trychlos/mysPowerS0/build/mysPowerS0.ods

Sheet: Notes
About mySensorsIDs
 | Homogeneize the namings : minPeriod, maxPeriod vs minFrequency, maxFrequency → choose one of Period or Frequency
 | Try to make pwiSensors simpler
About Board
 | Have a switch to on/off the power of the board
 | Have better external connections

Sheet: NanoConnections
 |  |  | Digital | Analog |  | MySensors | NRF24L01 |  | DRS155D n° 1 | DRS155D n° 2 | DRS155D n° 3 | DRS155D n° 4
1 | TX | Reserved UART |  |  | PCINT2 Port D
2 | RX | Reserved UART
3 | RST
4 | GND |  |  |  |  |  | 1 | GND | So - | So - | So - | So -
5 | D2 / IRQ0 |  |  |  |  |  | 5 | IRQ
6 | D3 / IRQ1 |  | √ |  |  |  |  |  | Enabled
7 | D4 |  | √ |  |  |  |  |  |  | Enabled
8 | D5 |  | √ |  |  |  |  |  |  |  | Enabled
9 | D6 |  | √ |  |  |  |  |  |  |  |  | Enabled
10 | D7 |  | √ |  |  |  |  |  | LED
11 | D8 |  | √ |  | PCINT0 Port B |  |  |  |  | LED
12 | D9 |  |  |  |  |  | 2 | CE
13 | D10 |  |  |  |  |  | 7 | CSN
14 | D11 |  |  |  |  |  | 6 | MOSI
15 | D12 |  |  |  |  |  | 4 | MISO
16 | D13 |  |  |  |  |  | 3 | SCK
17 | 3V3 |  |  |  |  |  | 8 | VCC
18 | AREF
19 | A0 |  | √ | √ | PCINT1 Port C |  |  |  | So +
20 | A1 |  | √ | √ |  |  |  |  |  | So +
21 | A2 |  | √ | √ |  |  |  |  |  |  | So +
22 | A3 |  | √ | √ |  |  |  |  |  |  |  | So +
23 | A4 |  | √ | √ |  |  |  |  |  |  | LED
24 | A5 |  | √ | √ |  |  |  |  |  |  |  | LED
25 | A6 |  |  | √
26 | A7 |  |  | √ |  | MY_RANDOMSEED_PIN
27 | +5V
28 | RST
29 | GND
30 | VIN

Sheet: mySensors IDs v4
Arduino sensor |  |  |  |  |  |  | mySensor event
Sens | Name | Alias | Id | Type | Comment | pwiSensor | Nature | Command | Message | Payload | Comment
Out | CHILD_MAIN+0 | CHILD_MAIN_LOG | 1 | S_INFO | General command target |  | Info |  | V_TEXT | <text> | Informations sent from the node to the controller, let the node send a textual log line
In | CHILD_MAIN+1 | CHILD_MAIN_ACTION_RESET | 2 | S_BINARY | General commands target |  | Action | C_SET | V_STATUS | 1=”ON” | EEPROM reset
In | CHILD_MAIN+2 | CHILD_MAIN_ACTION_DUMP | 3 | S_BINARY | General commands target |  | Action | C_SET | V_STATUS | 1=”ON” | Dump data
In | CHILD_MAIN+3 | CHILD_MAIN_ACTION_SAVE | 4 | S_BINARY | General commands target |  | Action | C_SET | V_STATUS | 1=”ON” | Write current energies into the EEPROM
In/Out | CHILD_MAIN+5 | CHILD_MAIN_PARM_SAVE_PERIOD | 6 | S_INFO | General commands target |  | Parm | C_SET | V_TEXT | <ms> | Set auto-save delay ; default=86400000 (24h)
In/Out | CHILD_MAIN+6 | CHILD_MAIN_PARM_DUMP_PERIOD | 7 | S_INFO | General command target |  | Parm | C_SET | V_TEXT | <ms> | set periodic resend of the full data ; 0 to disable ; default=86400000 (24h)
In/Out | CHILD_MAIN+7 | CHILD_MAIN_PARM_MIN_PERIOD | 8 | S_INFO | General command target |  | Parm | C_SET | V_TEXT | <ms> | min period of the measures
In/Out | CHILD_MAIN+8 | CHILD_MAIN_PARM_MAX_PERIOD | 9 | S_INFO | General command target |  | Parm | C_SET | V_TEXT | <ms> | max period of the measures
Out | CHILD_ID_PULSE_1 |  | 10 | S_POWER | Module n° 1 | pwiSensor | Info |  | V_WATT, V_KWH |  | Puissance, énergie
In/Out | CHILD_ID_PULSE_1+1 |  | 11 | S_INFO | Module n° 1 |  | Parm | C_SET | V_TEXT | <impkwh> | count of impulsions per kwh ; default=0
In/Out | CHILD_ID_PULSE_1+2 |  | 12 | S_INFO | Module n° 1 |  | Parm | C_SET | V_TEXT | <implen> | impulsion length ; default=0
In/Out | CHILD_ID_PULSE_1+3 |  | 13 | S_INFO | Module n° 1 |  | Parm | C_SET | V_TEXT | <name> | measure module name ; default=””
In/Out | CHILD_ID_PULSE_1+4 |  | 14 | S_INFO | Module n° 1 |  | Parm | C_SET | V_TEXT | <kwh> | set current energy measure once, so that the energy sent is aligned on the module display this is sent back to the controller when set, but never sent back again, nor stored, nor reused in anyway
Out | CHILD_ID_PULSE_2 |  | 20 | S_POWER | Module n° 1 | pwiSensor | Info |  | V_WATT, V_KWH |  | Puissance, énergie
In/Out | CHILD_ID_PULSE_2+1 |  | 21 | S_INFO | Module n° 1 |  | Parm | C_SET | V_TEXT | <impkwh> | count of impulsions per kwh ; default=0
In/Out | CHILD_ID_PULSE_2+2 |  | 22 | S_INFO | Module n° 1 |  | Parm | C_SET | V_TEXT | <implen> | impulsion length ; default=0
In/Out | CHILD_ID_PULSE_2+3 |  | 23 | S_INFO | Module n° 1 |  | Parm | C_SET | V_TEXT | <name> | measure module name ; default=””
In/Out | CHILD_ID_PULSE_2+4 |  | 24 | S_INFO | Module n° 1 |  | Parm | C_SET | V_TEXT | <kwh> | set current energy measure once, so that the energy sent is aligned on the module display this is sent back to the controller when set, but never sent back again, nor stored, nor reused in anyway
Out | CHILD_ID_PULSE_3 |  | 30 | S_POWER | Module n° 1 | pwiSensor | Info |  | V_WATT, V_KWH |  | Puissance, énergie
In/Out | CHILD_ID_PULSE_3+1 |  | 31 | S_INFO | Module n° 1 |  | Parm | C_SET | V_TEXT | <impkwh> | count of impulsions per kwh ; default=0
In/Out | CHILD_ID_PULSE_3+2 |  | 32 | S_INFO | Module n° 1 |  | Parm | C_SET | V_TEXT | <implen> | impulsion length ; default=0
In/Out | CHILD_ID_PULSE_3+3 |  | 33 | S_INFO | Module n° 1 |  | Parm | C_SET | V_TEXT | <name> | measure module name ; default=””
In/Out | CHILD_ID_PULSE_3+4 |  | 34 | S_INFO | Module n° 1 |  | Parm | C_SET | V_TEXT | <kwh> | set current energy measure once, so that the energy sent is aligned on the module display this is sent back to the controller when set, but never sent back again, nor stored, nor reused in anyway
Out | CHILD_ID_PULSE_4 |  | 40 | S_POWER | Module n° 1 | pwiSensor | Info |  | V_WATT, V_KWH |  | Puissance, énergie
In/Out | CHILD_ID_PULSE_4+1 |  | 41 | S_INFO | Module n° 1 |  | Parm | C_SET | V_TEXT | <impkwh> | count of impulsions per kwh ; default=0
In/Out | CHILD_ID_PULSE_4+2 |  | 42 | S_INFO | Module n° 1 |  | Parm | C_SET | V_TEXT | <implen> | impulsion length ; default=0
In/Out | CHILD_ID_PULSE_4+3 |  | 43 | S_INFO | Module n° 1 |  | Parm | C_SET | V_TEXT | <name> | measure module name ; default=””
In/Out | CHILD_ID_PULSE_4+4 |  | 44 | S_INFO | Module n° 1 |  | Parm | C_SET | V_TEXT | <kwh> | set current energy measure once, so that the energy sent is aligned on the module display This is sent back to the controller when set, but never sent back again, nor stored, nor reused in anyway

Sheet: mySensors IDs v3
Arduino sensor |  |  |  |  |  | mySensor event
Sens | Name | Id | Type | Comment | pwiSensor | Nature | Command | Message | Payload | Comment
In | CHILD_MAIN | 1 | S_CUSTOM | General commands target |  | Action | C_REQ | V_CUSTOM | 1 | EEPROM reset
In | CHILD_MAIN | 1 | S_CUSTOM | General commands target |  | Action | C_REQ | V_CUSTOM | 2 | Dump data
In | CHILD_MAIN | 1 | S_CUSTOM | General commands target |  | Action | C_REQ | V_CUSTOM | 3 | Write current energies into the EEPROM
In | CHILD_MAIN+1 | 2 | S_CUSTOM | General commands target |  | Action | C_SET | V_CUSTOM | <ms> | Set max frequency of the messages (minPeriod) ; default = 10000 (10s)
Out | CHILD_MAIN+1 | 2 | S_CUSTOM | General commands target |  | Info |  | V_VAR1 | <ms> | Max frequency of the messages (minPeriod)
In | CHILD_MAIN+2 | 3 | S_CUSTOM | General commands target |  | Action | C_SET | V_CUSTOM | <ms> | Set unchanged timeout of the messages (maxPeriod) ; default = 3600000 (1h)
Out | CHILD_MAIN+2 | 3 | S_CUSTOM | General commands target |  | Info |  | V_VAR1 | <ms> | Unchanged timeout of the messages (maxPeriod)
In | CHILD_MAIN+3 | 4 | S_CUSTOM | General commands target |  | Action | C_REQ | V_CUSTOM |  | Request count of enabled modules
Out | CHILD_MAIN+3 | 4 | S_CUSTOM | General commands target |  | Info |  | V_VAR1 | <count> | Count of enabled modules
In | CHILD_MAIN+4 | 5 | S_CUSTOM | General commands target |  | Action | C_SET | V_CUSTOM | <ms> | Set auto-save delay ; default = 604800000 (1 sem.)
Out | CHILD_MAIN+4 | 5 | S_CUSTOM | General commands target |  | Info |  | V_VAR1 | <ms> | Auto-save delay
In | CHILD_MAIN+5 | 6 | S_CUSTOM | General commands target |  | Action | C_SET | V_CUSTOM | <ms> | Set periodic resend of the full data ; 0 to disable ; default=86400000 (24h)
Out | CHILD_MAIN+5 | 6 | S_CUSTOM | General commands target |  | Info |  | V_VAR1 | <ms> | Periodic resend period of the full data
Out | CHILD_ID_PULSE_1 | 10 | S_POWER | Module n° 1 | pwiSensor | Info |  | V_WATT |  | Puissance instantanée
Out | CHILD_ID_PULSE_1+1 | 11 | S_POWER | Module n° 1 |  | Info |  | V_KWH |  | Consommation cumulée depuis le démarrage
In | CHILD_ID_PULSE_1+2 | 12 | S_POWER | Module n° 1 |  | Action | C_SET | V_CUSTOM | <impkwh> | set count of impulsions per kwh ; default = 1000 imp/kwh
Out | CHILD_ID_PULSE_1+2 | 12 | S_POWER | Module n° 1 |  | Info |  | V_VAR1 | <impkwh> | count of impulsions per kwh
In | CHILD_ID_PULSE_1+3 | 13 | S_POWER | Module n° 1 |  | Action | C_SET | V_CUSTOM | <implen> | set impulsion length ; default = 90 ms
Out | CHILD_ID_PULSE_1+3 | 13 | S_POWER | Module n° 1 |  | Info |  | V_VAR1 | <implen> | impulsion length
In | CHILD_ID_PULSE_1+4 | 14 | S_POWER | Module n° 1 |  | Action | C_SET | V_CUSTOM | <name> | set measure module name (e.g. DRS-155D)
Out | CHILD_ID_PULSE_1+4 | 14 | S_POWER | Module n° 1 |  | Info |  | V_VAR1 | <name> | module name
Out | CHILD_ID_PULSE_1+5 | 15 | S_POWER | Module n° 1 |  | Info |  | V_VAR1 | 1|0 | Whether the module is enabled
In | CHILD_ID_PULSE_1+6 | 16 | S_POWER | Module n° 1 |  | Action | C_SET | V_CUSTOM | <kwh> | set current DRS155-D measure
Out | CHILD_ID_PULSE_2 | 20 | S_POWER | Module n° 2 | pwiSensor | Info |  | V_WATT |  | Puissance instantanée
Out | CHILD_ID_PULSE_2+1 | 21 | S_POWER | Module n° 2 |  | Info |  | V_KWH |  | Consommation cumulée depuis le démarrage
In | CHILD_ID_PULSE_2+2 | 22 | S_POWER | Module n° 2 |  | Action | C_SET | V_CUSTOM | <impkwh> | set count of impulsions per kwh ; default = 1000 imp/kwh
Out | CHILD_ID_PULSE_2+2 | 22 | S_POWER | Module n° 2 |  | Info |  | V_VAR1 | <impkwh> | count of impulsions per kwh
In | CHILD_ID_PULSE_2+3 | 23 | S_POWER | Module n° 2 |  | Action | C_SET | V_CUSTOM | <implen> | set impulsion length ; default = 90 ms
Out | CHILD_ID_PULSE_2+3 | 23 | S_POWER | Module n° 2 |  | Info |  | V_VAR1 | <implen> | impulsion length
In | CHILD_ID_PULSE_2+4 | 24 | S_POWER | Module n° 2 |  | Action | C_SET | V_CUSTOM | <name> | set measure module name (e.g. DRS-155D)
Out | CHILD_ID_PULSE_2+4 | 24 | S_POWER | Module n° 2 |  | Info |  | V_VAR1 | <name> | module name
Out | CHILD_ID_PULSE_2+5 | 25 | S_POWER | Module n° 2 |  | Info |  | V_VAR1 | 1|0 | Whether the module is enabled
In | CHILD_ID_PULSE_2+6 | 26 | S_POWER | Module n° 2 |  | Action | C_SET | V_CUSTOM | <kwh> | set current DRS155-D measure
Out | CHILD_ID_PULSE_3 | 30 | S_POWER | Module n° 3 | pwiSensor | Info |  | V_WATT |  | Puissance instantanée
Out | CHILD_ID_PULSE_3+1 | 31 | S_POWER | Module n° 3 |  | Info |  | V_KWH |  | Consommation cumulée depuis le démarrage
In | CHILD_ID_PULSE_3+2 | 32 | S_POWER | Module n° 3 |  | Action | C_SET | V_CUSTOM | <impkwh> | set count of impulsions per kwh ; default = 1000 imp/kwh
Out | CHILD_ID_PULSE_3+2 | 32 | S_POWER | Module n° 3 |  | Info |  | V_VAR1 | <impkwh> | count of impulsions per kwh
In | CHILD_ID_PULSE_3+3 | 33 | S_POWER | Module n° 3 |  | Action | C_SET | V_CUSTOM | <implen> | set impulsion length ; default = 90 ms
Out | CHILD_ID_PULSE_3+3 | 33 | S_POWER | Module n° 3 |  | Info |  | V_VAR1 | <implen> | impulsion length
In | CHILD_ID_PULSE_3+4 | 34 | S_POWER | Module n° 3 |  | Action | C_SET | V_CUSTOM | <name> | set measure module name (e.g. DRS-155D)
Out | CHILD_ID_PULSE_3+4 | 34 | S_POWER | Module n° 3 |  | Info |  | V_VAR1 | <name> | module name
Out | CHILD_ID_PULSE_3+5 | 35 | S_POWER | Module n° 3 |  | Info |  | V_VAR1 | 1|0 | Whether the module is enabled
In | CHILD_ID_PULSE_3+6 | 36 | S_POWER | Module n° 3 |  | Action | C_SET | V_CUSTOM | <kwh> | set current DRS155-D measure
Out | CHILD_ID_PULSE_4 | 40 | S_POWER | Module n° 4 | pwiSensor | Info |  | V_WATT |  | Puissance instantanée
Out | CHILD_ID_PULSE_4+1 | 41 | S_POWER | Module n° 4 |  | Info |  | V_KWH |  | Consommation cumulée depuis le démarrage
In | CHILD_ID_PULSE_4+2 | 42 | S_POWER | Module n° 4 |  | Action | C_SET | V_CUSTOM | <impkwh> | set count of impulsions per kwh ; default = 1000 imp/kwh
Out | CHILD_ID_PULSE_4+2 | 42 | S_POWER | Module n° 4 |  | Info |  | V_VAR1 | <impkwh> | count of impulsions per kwh
In | CHILD_ID_PULSE_4+3 | 43 | S_POWER | Module n° 4 |  | Action | C_SET | V_CUSTOM | <implen> | set impulsion length ; default = 90 ms
Out | CHILD_ID_PULSE_4+3 | 43 | S_POWER | Module n° 4 |  | Info |  | V_VAR1 | <implen> | impulsion length
In | CHILD_ID_PULSE_4+4 | 44 | S_POWER | Module n° 4 |  | Action | C_SET | V_CUSTOM | <name> | set measure module name (e.g. DRS-155D)
Out | CHILD_ID_PULSE_4+4 | 44 | S_POWER | Module n° 4 |  | Info |  | V_VAR1 | <name> | module name
Out | CHILD_ID_PULSE_4+5 | 45 | S_POWER | Module n° 4 |  | Info |  | V_VAR1 | 1|0 | Whether the module is enabled
In | CHILD_ID_PULSE_4+6 | 46 | S_POWER | Module n° 4 |  | Action | C_SET | V_CUSTOM | <kwh> | set current DRS155-D measure
