trychlos/mysPowerS0/build/mysPowerS0.sch

## KiCad design build/mysPowerS0.sch (2017-04-17)

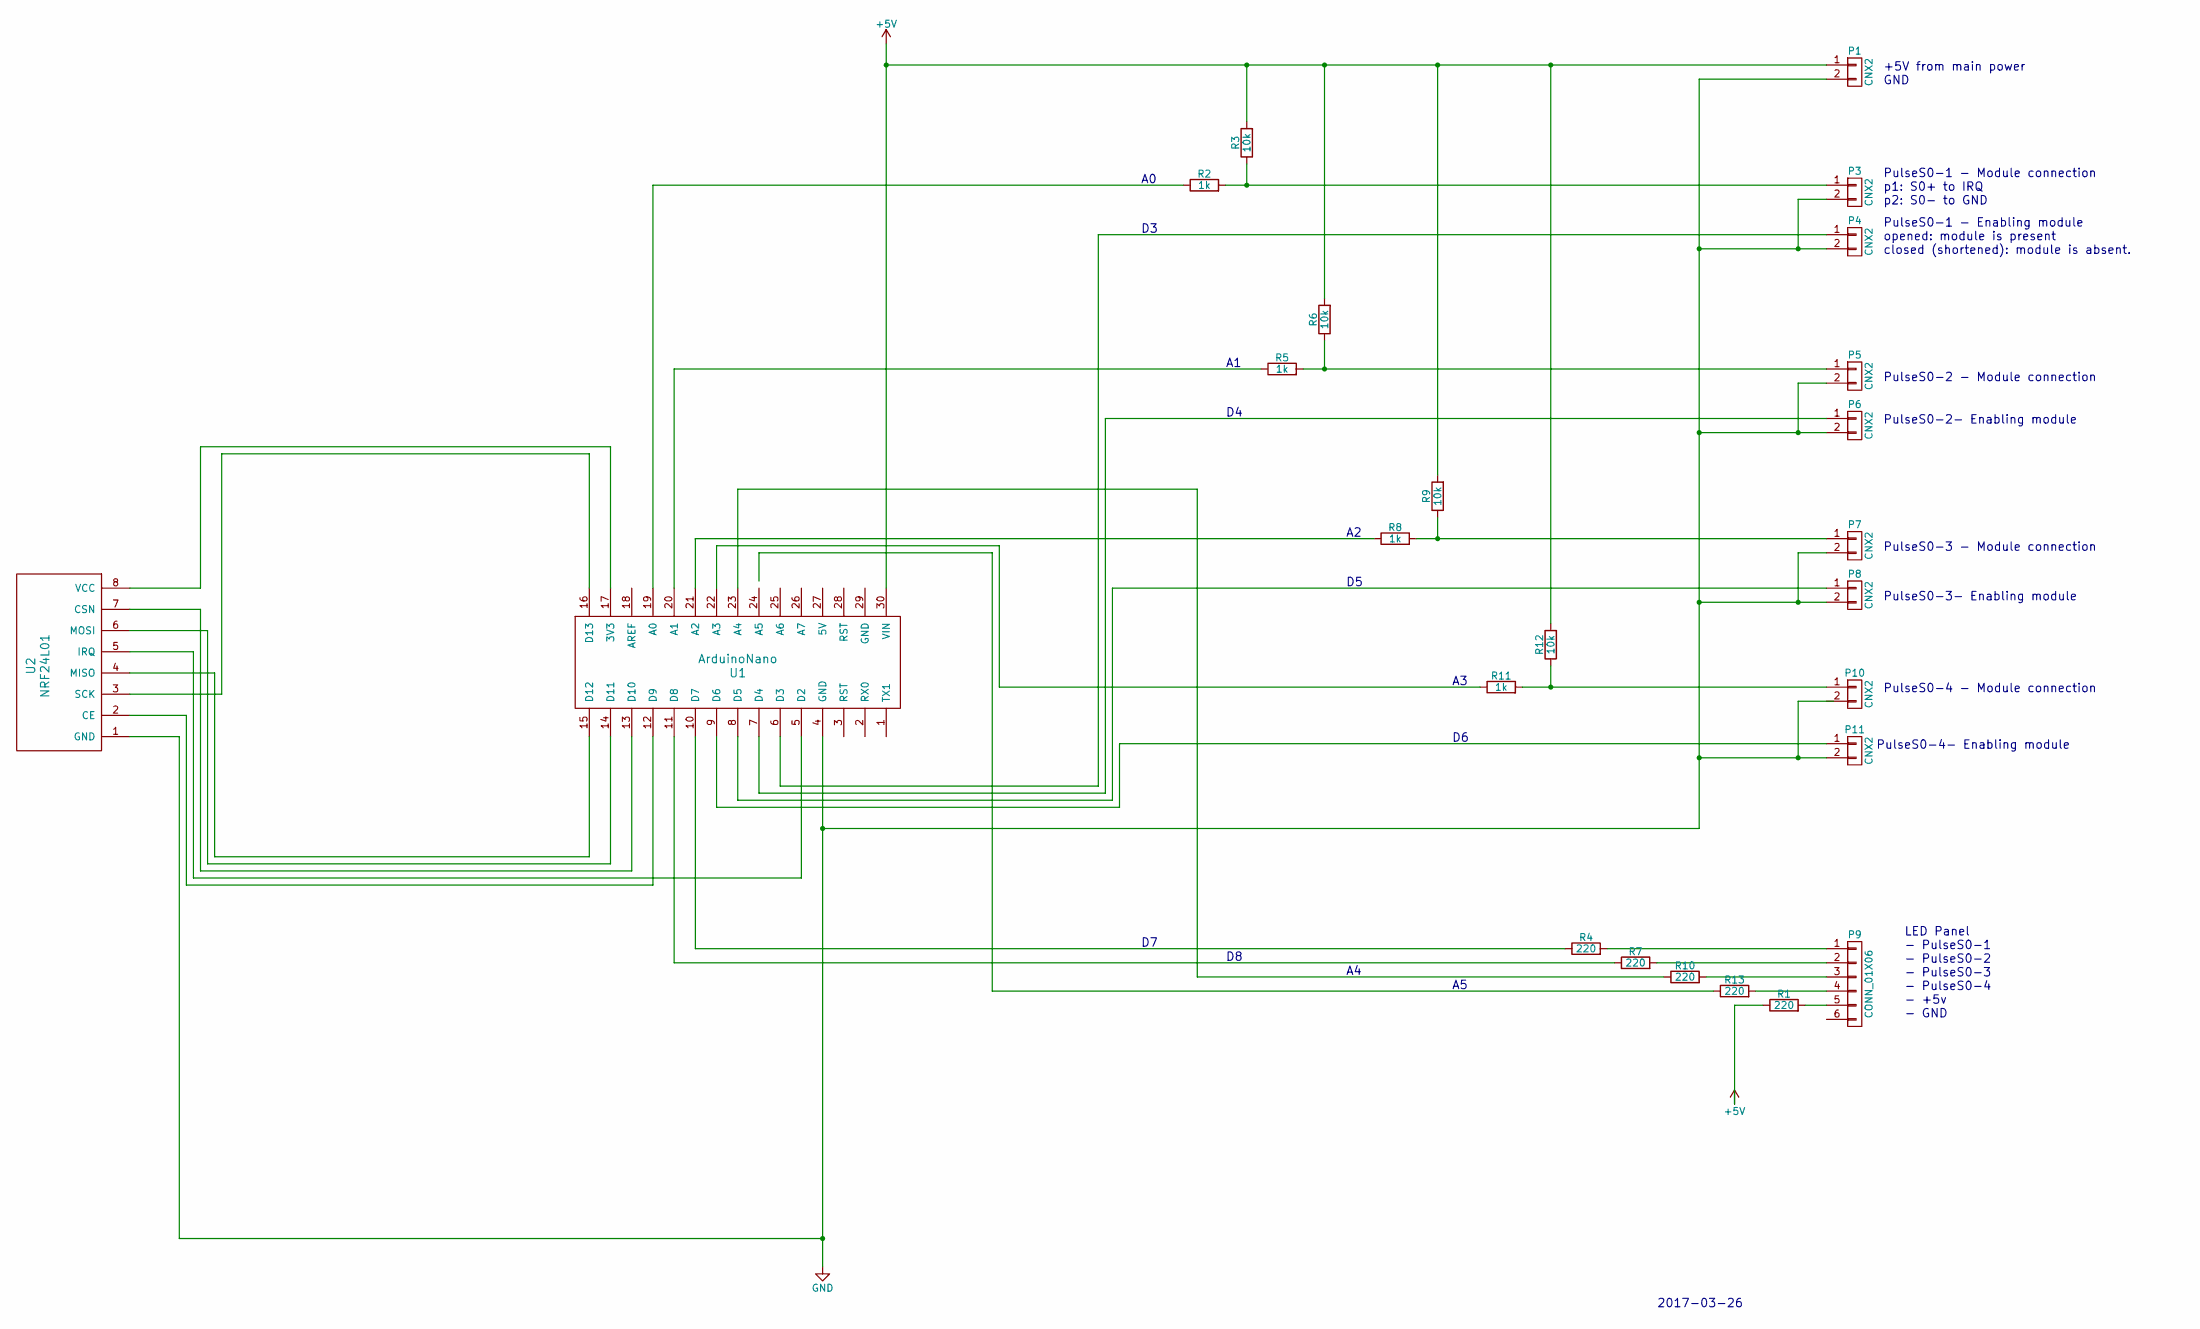
[picture p1: schematic mysPowerS0.sch]

Parts:
P1, P3, P4, P5, P6, P7, P8, P10, P11: CNX2
P9: CONN_01X06
R1, R4, R7, R10, R13: 220
R2, R5, R8, R11: 1k
R3, R6, R9, R12: 10k
U1: ArduinoNano
U2: NRF24L01

Connections:
+5V: P1.1, R1.1, R3.2, R6.2, R9.2, R12.2, U1.30 (VIN)
GND: P1.2, P3.2, P4.2, P5.2, P6.2, P7.2, P8.2, P11.2, U1.4 (GND), U2.1 (GND)
unnamed: P3.1, R2.2, R3.1
unnamed: P4.1, U1.6 (D3)
unnamed: P5.1, R5.2, R6.1
unnamed: P6.1, U1.7 (D4)
unnamed: P7.1, R8.2, R9.1
unnamed: P8.1, U1.8 (D5)
unnamed: P9.1, R4.2
unnamed: P9.2, R7.2
unnamed: P9.3, R10.2
unnamed: P9.4, R13.2
unnamed: P9.5, R1.2
unnamed: P10.1, R11.2, R12.1
unnamed: P11.1, U1.9 (D6)
unnamed: R2.1, U1.19 (A0)
unnamed: R4.1, U1.10 (D7)
unnamed: R5.1, U1.20 (A1)
unnamed: R7.1, U1.11 (D8)
unnamed: R8.1, U1.21 (A2)
unnamed: R10.1, U1.23 (A4)
unnamed: R11.1, U1.22 (A3)
unnamed: U1.5 (D2), U2.5 (IRQ)
unnamed: U1.12 (D9), U2.2 (CE)
unnamed: U1.13 (D10), U2.7 (CSN)
unnamed: U1.14 (D11), U2.6 (MOSI)
unnamed: U1.15 (D12), U2.4 (MISO)
unnamed: U1.16 (D13), U2.3 (SCK)
unnamed: U1.17 (3V3), U2.8 (VCC)

Notes on the sheet:
+5V from main power GND
2017-03-26
PulseS0-1 - Module connection p1: S0+ to IRQ p2: S0- to GND
PulseS0-1 - Enabling module opened: module is present closed (shortened): module is absent.
PulseS0-3 - Module connection
PulseS0-3- Enabling module
LED Panel - PulseS0-1 - PulseS0-2 - PulseS0-3 - PulseS0-4 - +5v - GND
PulseS0-2 - Module connection
PulseS0-2- Enabling module
PulseS0-4 - Module connection
PulseS0-4- Enabling module
