trychlos/mysPowerS0/(commit log)

2019-06-01 mysPowerS0: full rewrite with pwiSensor
    [NanoConnections.ods, Sheets.ods]
2019-06-01 Sheets: review the children node ids
    [Sheets.ods]
2019-06-04 mysPowerS0: fix bugs
    - present autodump delay sensor (todo #4)
    - send power with one decimal digit (todo #5)
    - force float value in set() method (todo #6).
    [mysPowerS0.ino]
2019-06-04 Update Sheets
    [Sheets.ods]
2019-09-15 mysPowerS0: rename Sheets.ods to mysPowerS0Sheets.ods
    [mysPowerS0Sheets.ods]
2019-10-06 build/mysPowerS0Sheets.ods: renamed to mysPowerS0.ods
    [mysPowerS0.ods]
2025-03-21 v3.0-2025 no more used interrupts + fix power computation
    [mysPowerS0.ods]
2025-03-21 Update docs
    [mysPowerS0.ods]
2025-03-22 Send power as an integer
2025-03-22 v3.1-2025 use PowerCounter derived from (new) pwiPulseSensor
2025-03-23 The enabled pin is actually a pullup one, and must be initialized as such
    [mysPowerS0.ods]
2025-08-02 Add debouncing and flash led on pulse
2025-08-04 Define +6 child_id to reset the internal counter (to be aligned with device display)
    [mysPowerS0.ods]
2025-09-30 Releasing v4.0-2025
    [mysPowerS0.ods]
2025-09-30 Releasing v4.1-2025: remove 'period=' prefix from configuration parameters
    [mysPowerS0.ods]
