trychlos/mysPowerS0/(notices)

Notices in the files:
mysPowerS0.ino:
modify it under the terms of the GNU General Public License
